LoKoNaoX/TFM_doc/listado.xlsx

Lista | Número de unidades | Medidas | Material | Impreso 3D | Lista | Número de unidades | Precio/u | Precio total aproximado
Ventiladores | 3 | 70mm |  |  | Reles | 3 | 5 | 15
Soporte ventilador | 3 | 70mm | PETG | Si | Sensor Óptico | 1 | 40 | 40
Tubo de enfriamiento | 1 | 310x30x30mm | Aluminio |  | Cables |  |  | 3.33
Pie | 2 |  | PETG | Si | Total |  |  | 58.33 €
Tornillos | 4 | M4
Lista | Número de unidades | Medidas | Material | Impreso 3D | Lista | Número de unidades | Precio/u | Precio total aproximado
Puntos guía | 2 |  | PVC |  | Motor paso a paso | 1 | 8 | 8
Soporte primera guía | 1 |  | PETG | Si | Sensor efecto hall lineal | 1 | 0.5 | 0.5
Soporte segunda guía | 1 |  | PETG | Si | Servo | 1 | 8 | 8
Tuercas | 2 | M8 | Aluminio |  | Cables |  |  | 3.33
Varilla roscada | 1 | M8 x 120mm | Aluminio |  | Total |  |  | 19.83 €
Sujecion motor paso a paso | 1 |  | PETG | Si
Soporte rodamiento pivote | 1 |  | PETG | Si
Rodamiento patines | 1 | Rext 22, Rint 8 mm
Guia rodamiento | 1 | Rext 24, Rint 22 mm | PETG | Si
Tuercas | 2 | M5 | Aluminio
Varilla roscada | 1 | M5 x 140 mm | Aluminio
Sensor espesor | 1 |  | PETG | Si
Soporte sensor espesor | 1 |  | PETG | Si
Rodamientos pequeños | 4 | 623ZZ
Muelle de boligrafo | 1
Iman | 1 | 25 x 6 x 2 mm
Tornillo | 1 | M6
Tornillos | 8 | M4
Lista | Número de unidades | Medidas | Material | Impreso 3D | Lista | Número de unidades | Precio/u | Precio total aproximado
Pies | 4 |  | PETG | Si | Motor paso a paso | 1 | 8 | 8
Pieza A soporte | 1 |  | PETG | Si | Cables |  |  | 3.33
Pieza B soporte | 1 |  | PETG | Si | Total |  |  | 11.33 €
Pieza C soporte | 1 |  | PETG | Si
Extension motor paso a paso | 1 | M5 a M8
Sujecion motor paso a paso | 1 |  | PETG | Si
Engranaje | 1 | Z = 13 | PETG | Si
Engranaje | 1 | Z = 58 | PETG | Si
Tornillo | 2 | M8 | Aluminio
Pasante vobina | 1 |  | PETG | Si
Bobinba vacia
Varilla roscada | 4 | M8 x 160mm | Aluminio
Tuercas | 19 | M8 | Aluminio
Tornillos | 10 | M4 | Aluminio
Arandelas |  | M8 | Aluminio
