LoKoNaoX/TFM_doc/(list of files, cad)

Other CAD files:
pdfs/_10_soporte_A.SLDDRW
pdfs/_11_soporte_B.SLDDRW
pdfs/_12_soporte_C.SLDDRW
pdfs/_13_engranaje_Z13.SLDDRW
pdfs/_14_engranaje_Z58.SLDDRW
pdfs/_15_pasante_bobina.SLDDRW
pdfs/_1_soporte_refrigerador.SLDDRW
pdfs/_2_soporte_guia_1.SLDDRW
pdfs/_3 soporte_guia_2.SLDDRW
pdfs/_4_soporte_motor_paso_paso.SLDDRW
pdfs/_5_soporte_rodamiento_pivote.SLDDRW
pdfs/_6_guia_rodamiento.SLDDRW
pdfs/_7_expansion_servo-varilla.SLDDRW
pdfs/_8_soporte_sensor_espesor.SLDDRW
pdfs/_9_pie_bobina.SLDDRW
