LoKoNaoX/TFM_doc/(commit log)

2022-09-01 añadido algunos enlaces de interes a struct
2022-09-04 empezado el punto 2.1.1 2.1.2
2022-09-07 Continuacion cap 2
    [listado.xlsx]
2022-09-08 finiquitao cp 2
    [listado.xlsx]
2022-09-19 bool motor programa
2022-09-20 parte materiales y resubida de ramps_ino
2022-10-03 Justificado todo lo que llevo
2022-10-03 Tutoria, comentar que hay que empezar con la accion de P y aumentar poco, muy poquito la parte D ya que es un sistema con retardo, ademas que la I tampoco puede ser muy grande para que actue bien, y 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
    [ramps.ino]
2022-10-10 en el final
    [listado.xlsx]
2022-10-12 code PID servo
2022-10-13 añadido a la doc servo-varilla
